Abd-El-Rhman-Saad/Smart-Delivery-Robot/images/IMG-20231230-WA0148.jpg

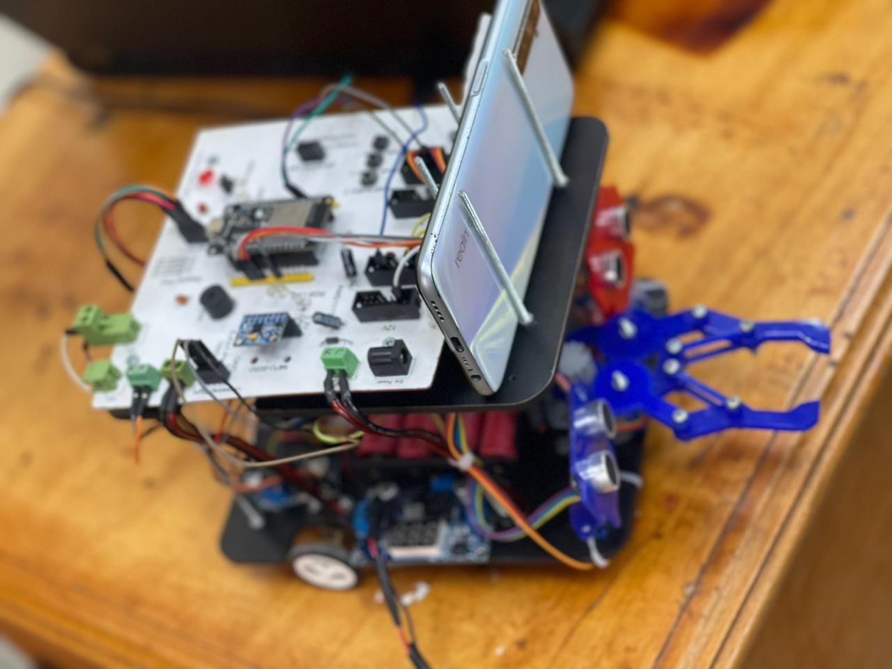
images/IMG-20231230-WA0148.jpg
