Abd-El-Rhman-Saad/Smart-Delivery-Robot/images/MVIMG_20231227_055445.jpg

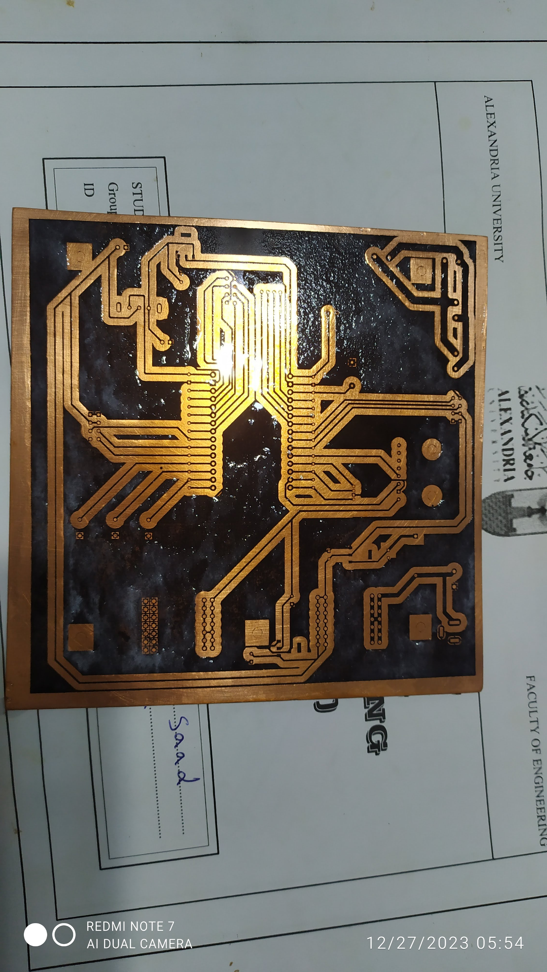
images/MVIMG_20231227_055445.jpg
