Abd-El-Rhman-Saad/Smart-Delivery-Robot/images/MVIMG_20231227_083012.jpg

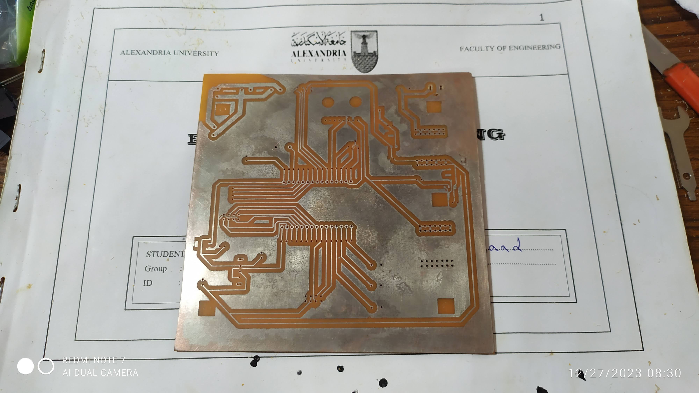
images/MVIMG_20231227_083012.jpg
