Abd-El-Rhman-Saad/Smart-Delivery-Robot/images/MVIMG_20231227_115744.jpg

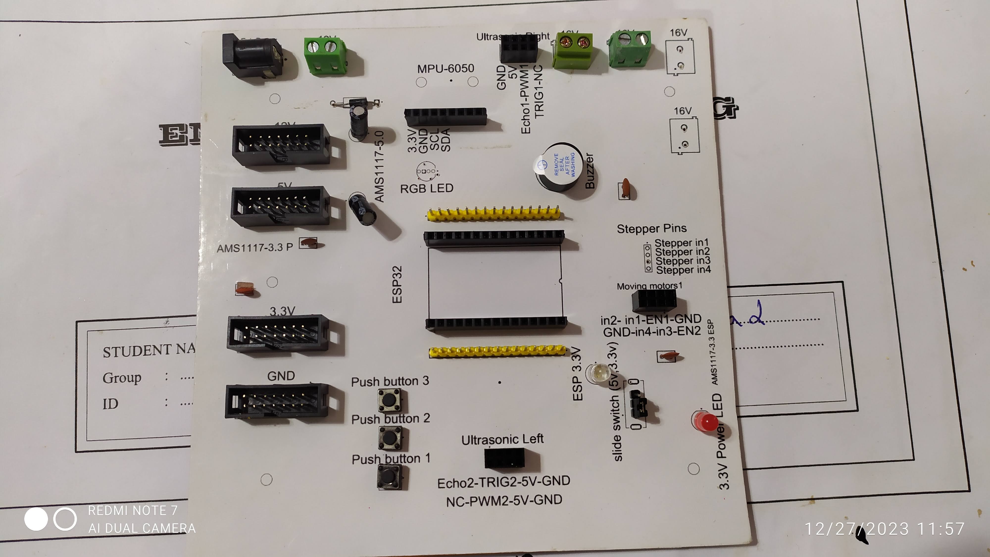
images/MVIMG_20231227_115744.jpg
