Abd-El-Rhman-Saad/Smart-Delivery-Robot/Hardware/Fabrication_Outputs/Schematic Prints.pdf

# Power Input

ESP32 BreakOut | Power Output

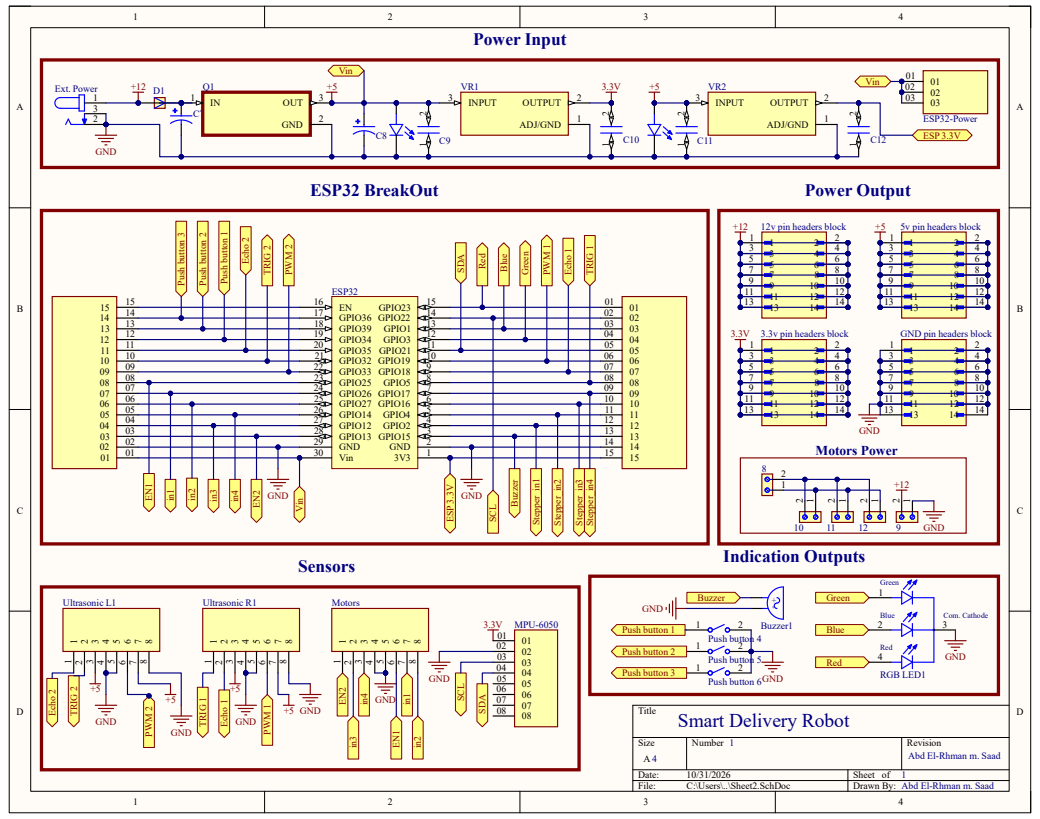
[picture p11: page 1]

GPIO36 17
GPIO39 18
GPIO34 19
GPIO35 20

GPIO12 27
GPIO13 28
GND 29
