Abd-El-Rhman-Saad/Smart-Delivery-Robot/Hardware/Fabrication_Outputs/Robot_Project.pdf

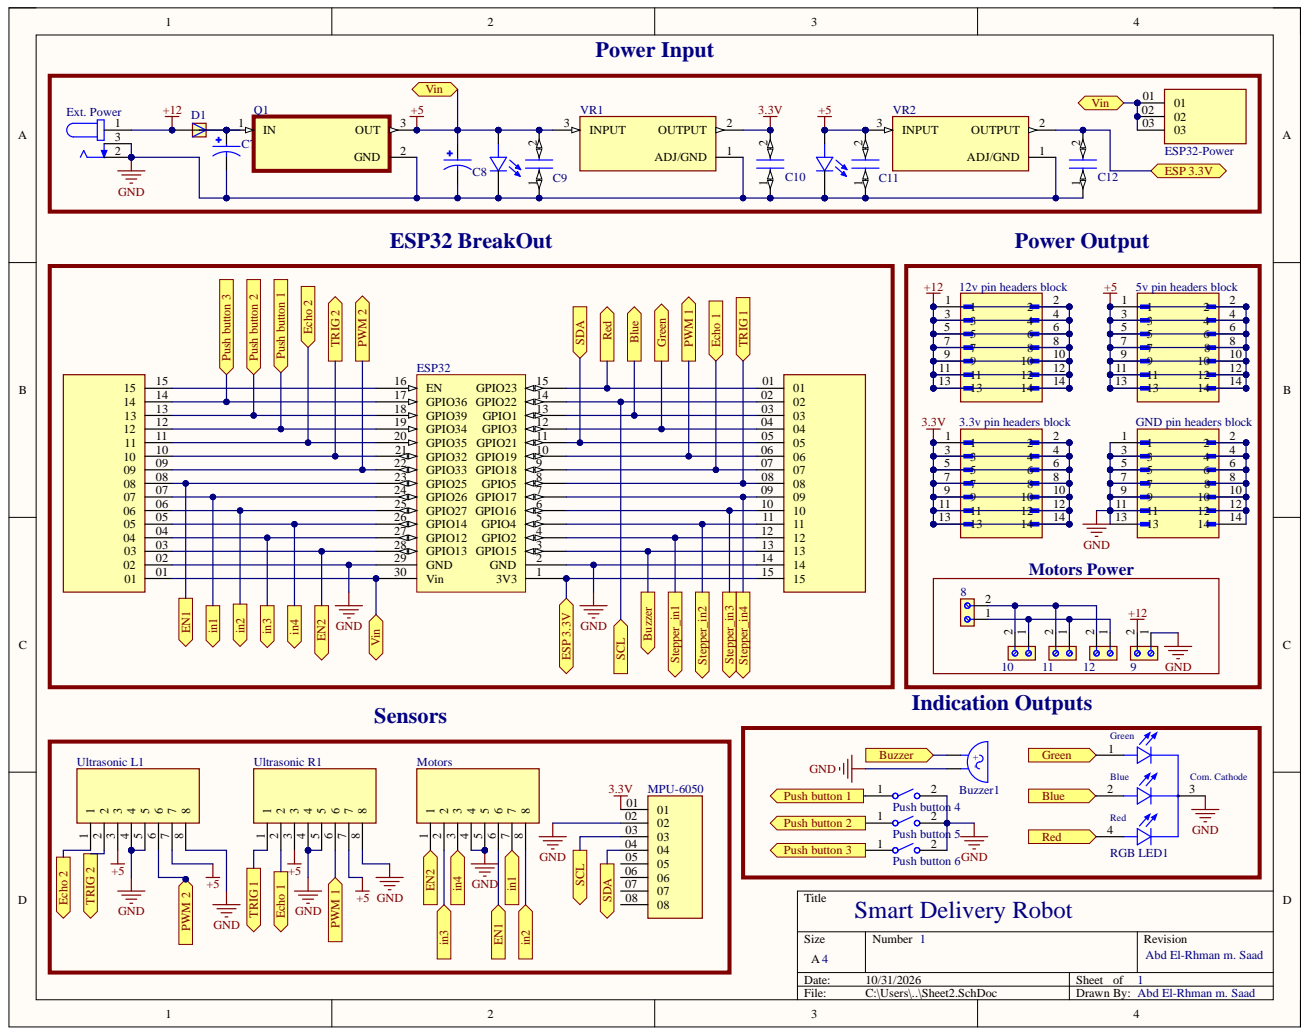
[picture p12: page 1]

GPIO13 28 | | 13 13

Vin 30 | | 15 15

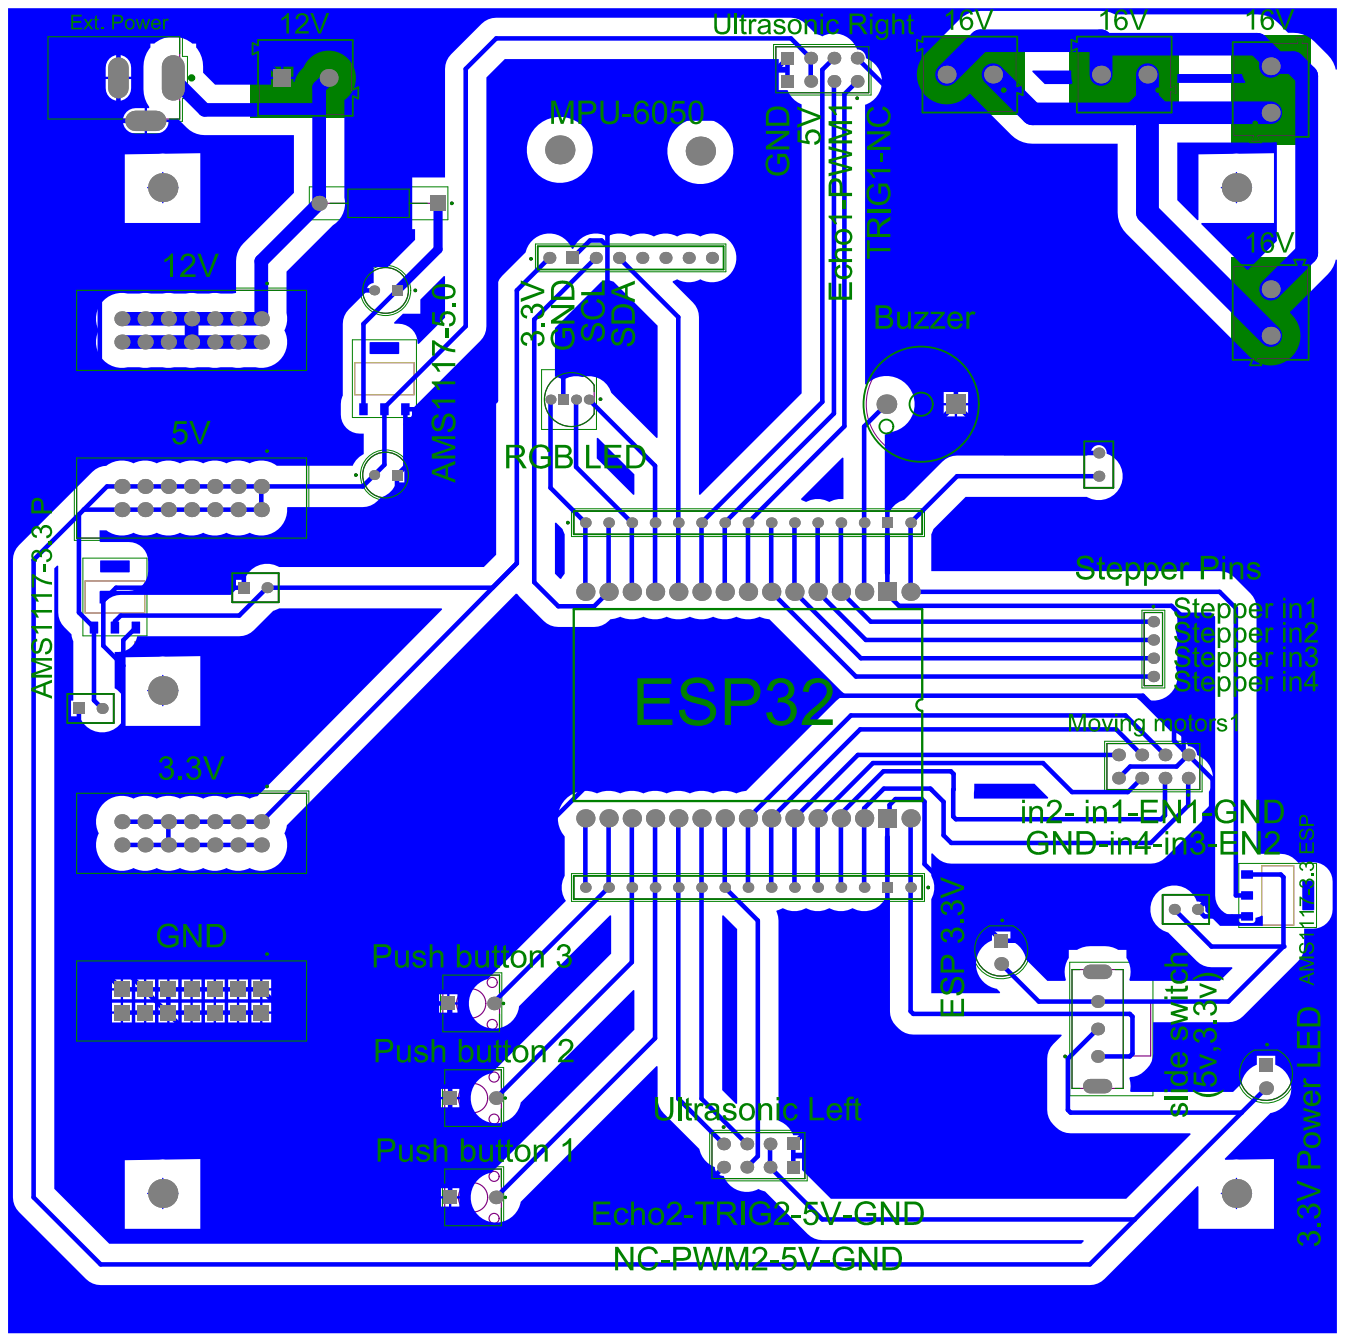
[picture p13: page 2]
