Abd-El-Rhman-Saad/Smart-Delivery-Robot/(list of files, drawings)

Other design files:
Hardware/Altium_Design/PCB1.PcbDoc
Hardware/Altium_Design/Robot_Project.PrjPcb
Hardware/Altium_Design/Sheet1_draft.SchDoc
Hardware/Altium_Design/Sheet2.SchDoc
