Abd-El-Rhman-Saad/Smart-Delivery-Robot/(commit log)

2026-11-03 feat: initial release of Smart Delivery Robot carrier board hardware & vision suite
    Comprehensive initial release containing the complete hardware engineering package, custom ESP32 carrier board PCB design, in-house chemical fabrication documentation, and team perception reference modules:
    1. Hardware & PCB Design (Hardware/):
    - Master Altium Designer 24 project (Robot_Project.PrjPcb) and 2-layer physical board layout (PCB1.PcbDoc).
    - Final production schematic (Sheet2.SchDoc) authored by Abd El-Rhman Saad alongside early concept draft (Sheet1_draft.SchDoc).
    - Complete multi-sheet vector schematics, 1:1 copper layer prints, and drill guides in Fabrication_Outputs/.
    2. Perception &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
    [PCB1.PcbDoc, Robot_Project.PrjPcb, Sheet1_draft.SchDoc, Sheet2.SchDoc]
2026-11-03 docs: integrate physical fabrication lifecycle & assembled prototype photo galleries into Smart Delivery Robot README
    - Added 4-stage chronological in-house PCB fabrication gallery: toner transfer pre-etching, chemically etched bare PCB, top-side component population, and bottom hand-soldering.
    - Added fully assembled mobile robot prototype showcase featuring custom carrier board, smartphone camera mount, and mechanical gripper.
    - Replaced raw high-resolution camera images with optimized web-ready assets in images/.
    - Updated repository structure tree and synchronized changes directly to Google Drive.
